eleven5150/smart-storage/README.md

# Smart storage
This project is my bachelor's degree work
