eleven5150/smart-storage/docs/РТЗ.docx

Gerb-BMSTU_01

| Министерство науки и высшего образования Российской Федерации Федеральное государственное бюджетное образовательное учреждение высшего образования «Московский государственный технический университет имени Н.Э. Баумана (национальный исследовательский университет)» (МГТУ им. Н.Э. Баумана)

ФАКУЛЬТЕТ «ИНФОРМАТИКА И СИСТЕМЫ УПРАВЛЕНИЯ» (ИУ)

КАФЕДРА «ПРОЕКТИРОВАНИЕ И ТЕХНОЛОГИЯ ПРОИЗВОДСТВА ЭА» (ИУ4)

РАСШИРЕННОЕ ТЕХНИЧЕСКОЕ ЗАДАНИЕ

на выполнение выпускной квалификационной

работы бакалавра

Тема квалификационной работы: «Устройство управления учетом электронных компонентов»

Студент ИУ4-83Б _________________ Кутаев К.С.

(Группа) (Подпись, дата)

Руководитель ВКР _________________ Гладких А.А.

(Подпись, дата)

Москва, 2022

# 1.1 НАИМЕНОВАНИЕ, НАЗНАЧЕНИЕ И ОБЛАСТЬ ПРИМЕНЕНИЯ.

1.1.1 Наименование разрабатываемого изделия – «Устройство управления учетом электронных компонентов».

1.1.2 Изделие предназначено для быстрого поиска места нахождения определенного электронного компонента в большом стеллаже или складе, а также для удобного ведения учета электронных компонентов и их быстрого добавления.

1.1.3 Применяется на рабочем месте инженеров-электронщиков, в небольших лабораториях электроники в виде устройства со светодиодной лентой, установленного на стеллаж с компонентами с возможностью подсветки ячейки, в которой находится нужный компонент.

1.1.4 «Устройство управления учетом электронных компонентов» подключается по Wi-Fi к серверу с базой данных, в которой хранятся электронные компоненты из стеллажа. Сервер расположен на одноплатном компьютере, подключенным к одной сети с устройством. На плате находится RFID считыватель, с возможностью считывания с RFID-меток информации о новых компонентах и добавления их в базу данных.

1.2 ОСНОВАНИЕ ДЛЯ РАЗРАБОТКИ.

1.2.1 Настоящее техническое задание разработано в соответствии с заданием ВКР бакалавра кафедры ИУ4 МГТУ им Н. Э. Баумана.

1.3 ЦЕЛЬ И НАЗНАЧЕНИЕ РАЗРАБОТКИ.

1.3.1 Цель разработки – создание «Устройства управления учетом электронных компонентов», предназначенного для быстрого поиска места нахождения определенного электронного компонента в большом стеллаже или складе, а также для удобного ведения учета электронных компонентов и их быстрого добавления.

1.3.2 «Устройство управления учетом электронных компонентов» должно иметь питание, достаточное для нормальный работы светодиодной ленты и работать в климатических условиях УХЛ 3.1.

# 1.4 ИСТОЧНИКИ РАЗРАБОТКИ.

1.4.1 Опыт, накопленный студентом в разработке устройств, использующих светодиоды в качестве индикации и опыт работы с базами данных.

1.4.2 Анализ источников информации об аналогах.

# 1.5 ПРИНЦИП ДЕЙСТВИЯ.

1.5.1 Для включения устройства необходимо подключить устройство к сети питания постоянного тока 5В по средствам USB кабеля USB Type-A на Micro-USB Type-B. После подачи питания на «Устройство управления учетом электронных компонентов» загорится светодиод, означающий правильную работу устройства.

Функционал режимов подсветки и добавления компонентов регулируются соответствующей версией внутреннего программного обеспечения УУЭК, в зависимости от назначения поставки, загружаемого непосредственно при выполнении заказа.

При передаче на Устройство данных о ячейке стеллажа, которую необходимо подсветить, Устройство зажигает необходимые светодиоды. Выключение подсветки происходит при бездействии в течении определенного времени, определяемого версией прошивки.

# 1.6 ОБЪЕКТ ОБРАБОТКИ.

1.6.1 Объект обработки – информация о номере ячейки, получаемая с предусмотренных в изделии устройств ввода.

# 1.7 ТЕХНИЧЕСКИЕ ТРЕБОВАНИЯ.

## 1.7.1 Требования по составу изделия.

1.7.1.1 Устройство управления учетом электронных компонентов предназначено для быстрого поиска места нахождения определенного компонента в большом стеллаже или складе, ведения учета компонентов в наличии, а также возможности быстрого добавления новых компонентов в базу данных с помощью RFID-меток.

1.7.1.2 В состав каждого изделия должны входить:

- «Устройство управления учетом электронных компонентов», далее по тексту УУЭК, со средствами упаковки, обеспечивающими его транспортирование и хранение;

- Одноплатный компьютер, с объемом постоянной памяти не менее 8 Гб, наличием Wi-Fi передатчика и возможностью установки операционной системы на основе ядра Linux;

- принадлежности и эксплуатационная документация, необходимые для выполнения работ по обслуживанию УУЭК в условиях эксплуатации и хранения;

1.7.1.3 Комплект ПО, необходимого для эксплуатации УУЭК:

- тестирование (подготовка к работе);

- копирования данных (перенос данных в персональный компьютер);

- расшифровки данных (получение и передача информации, хранящейся на внутренней flash-памяти).

1.7.1.4 В состав устройства входят:

- МК STM32F103RDT6;

- кварцевый резонатор;

- 74 керамических конденсатора;

- импульсный регулятор питания;

- 61 светодиод;

- предохранитель;

- катушка индуктивности;

- 13 резисторов;

- ползунковый переключатель;

- тактовая кнопка;

- транзистор;

- вилка штыревая;

- гнездо контактное.

1.7.1.5 Разрабатываемое устройство должно быть выполнено в виде одноплатной электронной ячейки на двухсторонней печатной плате, заключенной в прямоугольный пластмассовый корпус.

## 1.7.2 Требования по назначению.

1.7.2.1 УУЭК должно обеспечивать прием и передачу информации, хранящейся на внутренней flash-памяти;

1.7.2.2 Изделие должно обеспечивать:

- вывод графической информации о нахождении компонента на светодиодной ленте;

- возможность ведения учета электронных компонентов в базе данных, и доступ к ней через веб-страницу;

- возможность ввода информации посредством веб-страницы, с последующей передачей данных по Wi-Fi и ввод посредством RFID считывателя;

1.7.2.4 Погрешность определения времени считывания данных с RFID-метки не должна превышать 2 с;

1.7.2.5 Электрическая прочность и сопротивление изоляции УУЭК – по ГОСТ Р 52931;

1.7.2.6 Напряжение питания – 5 В с погрешностью 0,5 В. Ток для питания УУЭК, обеспечиваемое ресурсом источника питания, - не менее 1 Ампера.

1.7.2.7 УУЭК должно сохранять работоспособность при температуре окружающей среды от -10 °C до 40 °C и относительной влажности воздуха 60% при температуре 25 °C.

1.7.2.8 Устройство должен сохранять работоспособность после его транспортирования и хранения при температуре (от минус 25 °C до 50 °C) в среде без агрессивных примесей (кислот, щелочей и др.).

1.7.2.9 Устройство должен сохранять работоспособность при воздействии на него вибрации на диапазоне частот от 10 до 100 Гц по ГОСТ 28203-89.

1.7.2.10 Устройство должен сохранять работоспособность при воздействии на него ударных нагрузок с ускорением до 10g длительностью до 15 мс и частотой от 40 до 80 1/мин. Вибрация в диапазоне частот от 10 до 100 Гц с ускорением до 1,5 g.

1.7.2.11 Масса Устройства - не более 0,3 кг.

1.7.2.12 Потребляемая мощность устройства не превышает 3 Вт.

1.7.2.13 Максимальный потребляемый ток – 500 мА.

1.7.2.14 Технология беспроводной передачи данных – Wi-Fi.

1.7.2.15 Максимальное количество зажигаемых светодиодов на светодиодной ленте – 6 шт.

1.7.2.15 Заданный объём выпуска Nвып= 1000 шт./год.

1.7.2.16 IP адреса устройств назначаются вручную при установке системы.

## 1.7.3 Требования к надежности.

1.7.3.1 Установленная вероятность безотказной работы УУЭК в течение наработки не менее 5000 часов должна быть не менее 0,95.

1.7.3.2 Средний срок службы УУЭК не менее 1,5 лет. Установленный срок службы - 1 год.

## 1.7.4 Требования к уровню унификации и стандартизации.

1.7.4.1 Требования к уровню унификации и стандартизации не предъявляются.

## 1.7.5 Требования безопасности и требования по охране природы.

1.7.5.1 УУЭК должен быть безопасными при использовании его пользователем, прочитавшим правилам эксплуатации устройства.

1.7.5.2 Блок питания и его компоненты должны быть правильно утилизированы.

1.7.5.3 В эксплуатационной документации на Устройство должны быть ссылки на общие требования безопасности в соответствии со следующими документами:

- ГОСТ 12.3.019 Испытания и измерения электрические. Общие требования безопасности;

- ГОСТ 12.2.003 Оборудование производственное. Общие требования безопасности;

- ГОСТ 12.3.020 Процессы перемещения грузов на предприятиях. Общие требования безопасности;

- ГОСТ 12.2.007.0 Изделия электротехнические. Общие требования безопасности;

- ГОСТ 12.1.004 Пожарная безопасность. Общие требования;

- ГОСТ 12.3.002 Процессы производственные. Общие требования безопасности;

1.7.5.4 Требования по охране природы не предъявляются, так как при изготовлении, эксплуатации, транспортировании, хранении, утилизации УУЭК отсутствуют вредные воздействия на элементы окружающей среды.

## 1.7.6 Требования к составным частям, сырью и исходным материалам.

## 1.7.6.1 Покупные изделия и материалы применяются без ограничений.

## 1.7.7 Условия эксплуатации, требования к техническому обслуживанию и ремонту.

1.7.7.1 УУЭК должно быть выполнено для климатической зоны УХЛ 3.1 по ГОСТ 15150.

1.7.7.2 УУЭК должно сохранять работоспособность при температуре среды от -10 °C до 40 °C и относительной влажности воздуха 60% при температуре 25 °C.

1.7.7.3 УУЭК должно сохранять работоспособность после его транспортирования и хранения при температуре от минус 25 °C до 50 °C в среде без агрессивных примесей.

1.7.7.4 Техническое обслуживание УУЭК должно обеспечиваться при проведении работ по их подготовке к обследованию объектов контроля, работ после проведения контроля и работ по подготовке к хранению.

1.7.7.5 Для увеличения достоверности информации, получаемой с установленных устройств ввода и вывода, допускается проведение периодической проверки и калибровки.

## 1.7.8 Требования к маркировке и упаковке.

1.7.8.1 Требования к маркировке не предъявляются.

## 1.7.9 Требования к транспортированию и хранению.

1.7.9.1 УУЭК должно выдерживать транспортирование в пассажирских салонах всех видов транспорта без ограничения расстояния перевозки.

# 1.8 ПОРЯДОК КОНТРОЛЯ И ПРИЕМКИ

1.8.1 Для приемки представляется один опытный образец платы печатной УУЭК, комплект эксплуатационных документов, комплект программного обеспечения, программа и методика приемных испытаний, согласованная в установленном порядке.

1.8.2 Конструкторская и технологическая документация должна быть разработана в соответствии с требованиями ГОСТ ЕСКД.

1.8.3 В комплекты эксплуатационных документов должны быть включены следующие документы:

– схема электрическая структурная электронной ячейки УУЭК (Э1),

– схема электрическая структурная УУЭК (Э1),

– схема электрическая принципиальная УУЭК (Э3),

– перечень элементов электронной ячейки УУЭК (ПЭ),

– чертеж печатной платы УУЭК(ПП),

– сборочный чертеж электронной ячейки УУЭК(СБ),

– спецификация электронной ячейки УУЭК(СП),

– чертежи основания и крышки корпуса УУЭК,

– сборочный чертёж УУЭК,

– спецификация УУЭК(СП),

– эскизный технологический процесс сборки УУЭК,

– алгоритм работы УУЭК,

– расчётно-пояснительная записка.

1.8.4 Приемные испытания УУЭК проводятся на образцах с искусственными или естественными дефектами, предоставляемыми заказчиком.

1.8.5 По результатам проведения испытаний, при необходимости проводится корректировка конструкторской документации.

1.8.6 Отдельные требования настоящего технического задания могут изменяться и дополняться по согласованию сторон в установленном порядке.
