eleven5150/smart-storage/cad-src/case/g1098b-g1098g.png

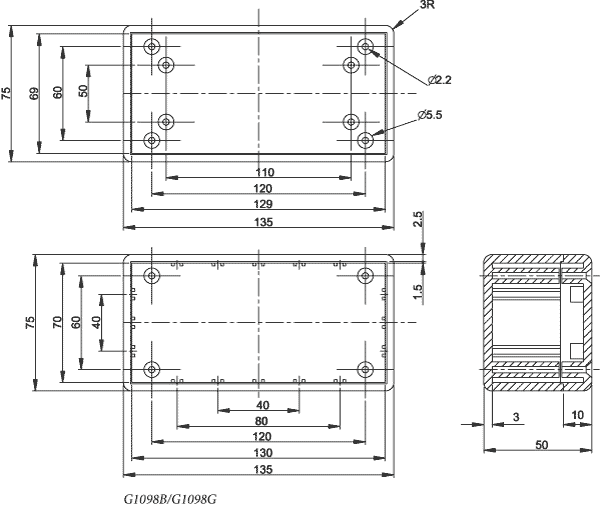
cad-src/case/g1098b-g1098g.png
