eleven5150/smart-storage/cad-src/case/Gainta G1098.STEP

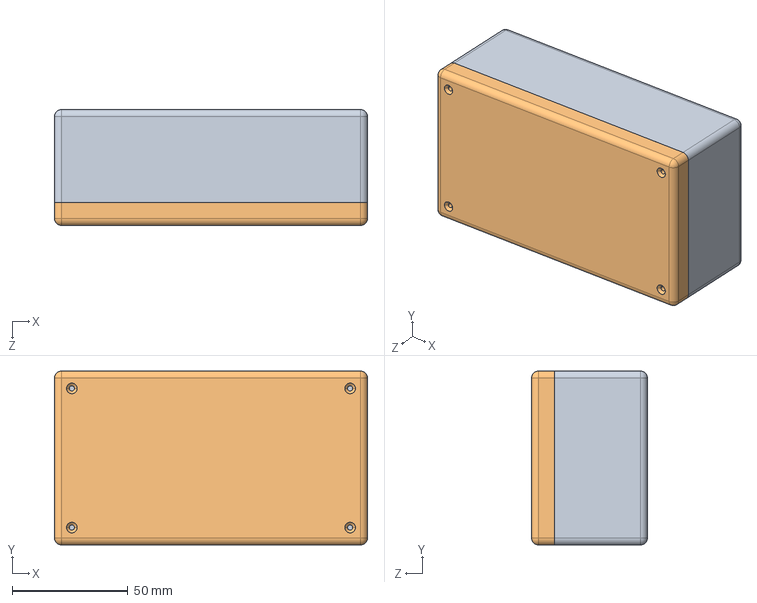
[picture p3: CAD file, 2022-06-20]
cad-src/case/Gainta G1098.STEP
135.0 x 75.0 x 50.0 mm
ﾎ魵瑙韃
Êðûøêà
