eleven5150/smart-storage/(list of files, cad)

Other CAD files:
cad-src/Altium/Diplom/Project Outputs for Diplom/AssemblyA.dwg
cad-src/Altium/Diplom/Project Outputs for Diplom/InventorNew/Assembly.dwg
cad-src/Altium/Diplom/Project Outputs for Diplom/AssemblyANew.dwg
cad-src/Altium/Diplom/Project Outputs for Diplom/Inventor/Сборочный.dwg
docs/Device/СП.dwg
docs/for print/Page2.dwg
docs/PCB/Э3.dwg
cad-src/Altium/Diplom/Project Outputs for Diplom/Inventor/PCBDiplomPCB.dwg
cad-src/case/Device.dwg
docs/Device/Алгоритм.dwg
docs/for print/Page1.dwg
docs/PCB/СборочныйA2.dwg
docs/Device/Эксперимент.dwg
docs/for print/Page3.dwg
docs/PCB/ПЭ3.dwg
docs/Device/Сборочный.dwg
docs/PCB/Сборочный.dwg
docs/Device/Крышка.dwg
docs/PCB/СП.dwg
docs/Device/Последовательность сборки.dwg
docs/PCB/ПП.dwg
docs/Device/ЭкспериментA3.dwg
docs/PCB/E1.dwg
docs/Device/Основание.dwg
docs/Device/E1 connection.dwg
docs/Device/Измерительный стенд.dwg
cad-src/Altium/Diplom/Project Outputs for Diplom/Inventor/PCB444.ipt
cad-src/Altium/Diplom/Project Outputs for Diplom/Inventor/PCB7459956112.iam
cad-src/Altium/Diplom/Project Outputs for Diplom/Inventor/PCBBoard.iam
cad-src/Altium/Diplom/Project Outputs for Diplom/Inventor/PCBC1.iam
cad-src/Altium/Diplom/Project Outputs for Diplom/Inventor/PCBC10.iam
cad-src/Altium/Diplom/Project Outputs for Diplom/Inventor/PCBC11.iam
cad-src/Altium/Diplom/Project Outputs for Diplom/Inventor/PCBC12.iam
cad-src/Altium/Diplom/Project Outputs for Diplom/Inventor/PCBC13.iam
cad-src/Altium/Diplom/Project Outputs for Diplom/Inventor/PCBC14.iam
cad-src/Altium/Diplom/Project Outputs for Diplom/Inventor/PCBC2.iam
cad-src/Altium/Diplom/Project Outputs for Diplom/Inventor/PCBC3.iam
cad-src/Altium/Diplom/Project Outputs for Diplom/Inventor/PCBC4.iam
cad-src/Altium/Diplom/Project Outputs for Diplom/Inventor/PCBC5.iam
cad-src/Altium/Diplom/Project Outputs for Diplom/Inventor/PCBC6.iam
cad-src/Altium/Diplom/Project Outputs for Diplom/Inventor/PCBC7.iam
cad-src/Altium/Diplom/Project Outputs for Diplom/Inventor/PCBC8.iam
cad-src/Altium/Diplom/Project Outputs for Diplom/Inventor/PCBC9.iam
cad-src/Altium/Diplom/Project Outputs for Diplom/Inventor/PCBCDRH104R.iam
cad-src/Altium/Diplom/Project Outputs for Diplom/Inventor/PCBDA1.iam
cad-src/Altium/Diplom/Project Outputs for Diplom/Inventor/PCBDD1.iam
cad-src/Altium/Diplom/Project Outputs for Diplom/Inventor/PCBDiplomPCB.iam
cad-src/Altium/Diplom/Project Outputs for Diplom/Inventor/PCBExtruded.ipt
cad-src/Altium/Diplom/Project Outputs for Diplom/Inventor/PCBF1.iam
cad-src/Altium/Diplom/Project Outputs for Diplom/Inventor/PCBFUSRC4632X90N.ipt
cad-src/Altium/Diplom/Project Outputs for Diplom/Inventor/PCBHL1.iam
cad-src/Altium/Diplom/Project Outputs for Diplom/Inventor/PCBL1.iam
cad-src/Altium/Diplom/Project Outputs for Diplom/Inventor/PCBLQFP64-10x10mm.ipt
cad-src/Altium/Diplom/Project Outputs for Diplom/Inventor/PCBOpen CASCADE STEP translator 6.8 1.1.1.ipt
cad-src/Altium/Diplom/Project Outputs for Diplom/Inventor/PCBPBD-8.ipt
cad-src/Altium/Diplom/Project Outputs for Diplom/Inventor/PCBR1.iam
cad-src/Altium/Diplom/Project Outputs for Diplom/Inventor/PCBR2.iam
cad-src/Altium/Diplom/Project Outputs for Diplom/Inventor/PCBR3.iam
cad-src/Altium/Diplom/Project Outputs for Diplom/Inventor/PCBR4.iam
cad-src/Altium/Diplom/Project Outputs for Diplom/Inventor/PCBR5.iam
cad-src/Altium/Diplom/Project Outputs for Diplom/Inventor/PCBR6.iam
cad-src/Altium/Diplom/Project Outputs for Diplom/Inventor/PCBR7.iam
cad-src/Altium/Diplom/Project Outputs for Diplom/Inventor/PCBSA1.iam
cad-src/Altium/Diplom/Project Outputs for Diplom/Inventor/PCBSB1.iam
cad-src/Altium/Diplom/Project Outputs for Diplom/Inventor/PCBSOT23-5.ipt
cad-src/Altium/Diplom/Project Outputs for Diplom/Inventor/PCBUser_Library-FYLS-1206.ipt
cad-src/Altium/Diplom/Project Outputs for Diplom/Inventor/PCBUser_Library-GeyerElectronics_KX7.ipt
cad-src/Altium/Diplom/Project Outputs for Diplom/Inventor/PCBUser_Library-PBS-08.ipt
cad-src/Altium/Diplom/Project Outputs for Diplom/Inventor/PCBUser_Library-PLS-1R.ipt
cad-src/Altium/Diplom/Project Outputs for Diplom/Inventor/PCBUser_Library-RES_2013-0805.ipt
cad-src/Altium/Diplom/Project Outputs for Diplom/Inventor/PCBUser_Library-SMD_CAPACITOR0805.ipt
cad-src/Altium/Diplom/Project Outputs for Diplom/Inventor/PCBUser_Library-SWT-34.ipt
cad-src/Altium/Diplom/Project Outputs for Diplom/Inventor/PCBUser_Library-cdrh104r_CDRH104R_KORPUS.ipt
cad-src/Altium/Diplom/Project Outputs for Diplom/Inventor/PCBUser_Library-cdrh104r_CDRH104R_NOGKA.ipt
cad-src/Altium/Diplom/Project Outputs for Diplom/Inventor/PCBUser_Library-cdrh104r_CDRH104R_NOGKA_1.ipt
cad-src/Altium/Diplom/Project Outputs for Diplom/Inventor/PCBUser_Library-micro_usb_SMD.ipt
cad-src/Altium/Diplom/Project Outputs for Diplom/Inventor/PCBUser_Library-sot23-1.ipt
cad-src/Altium/Diplom/Project Outputs for Diplom/Inventor/PCBVT1.iam
cad-src/Altium/Diplom/Project Outputs for Diplom/Inventor/PCBXP1.iam
cad-src/Altium/Diplom/Project Outputs for Diplom/Inventor/PCBXP2.iam
cad-src/Altium/Diplom/Project Outputs for Diplom/Inventor/PCBXS1.iam
cad-src/Altium/Diplom/Project Outputs for Diplom/Inventor/PCBXS2.iam
cad-src/Altium/Diplom/Project Outputs for Diplom/Inventor/PCBXS3.iam
cad-src/Altium/Diplom/Project Outputs for Diplom/Inventor/PCBXS4.iam
cad-src/Altium/Diplom/Project Outputs for Diplom/Inventor/PCBZQ1.iam
cad-src/Altium/Diplom/Project Outputs for Diplom/Inventor/Крышка.ipt
cad-src/Altium/Diplom/Project Outputs for Diplom/Inventor/Основание.ipt
cad-src/Altium/Diplom/Project Outputs for Diplom/InventorNew/PCB444.ipt
cad-src/Altium/Diplom/Project Outputs for Diplom/InventorNew/PCB7202516656.iam
cad-src/Altium/Diplom/Project Outputs for Diplom/InventorNew/PCBBoard.iam
cad-src/Altium/Diplom/Project Outputs for Diplom/InventorNew/PCBC1.iam
cad-src/Altium/Diplom/Project Outputs for Diplom/InventorNew/PCBC10.iam
cad-src/Altium/Diplom/Project Outputs for Diplom/InventorNew/PCBC11.iam
cad-src/Altium/Diplom/Project Outputs for Diplom/InventorNew/PCBC12.iam
cad-src/Altium/Diplom/Project Outputs for Diplom/InventorNew/PCBC13.iam
cad-src/Altium/Diplom/Project Outputs for Diplom/InventorNew/PCBC14.iam
cad-src/Altium/Diplom/Project Outputs for Diplom/InventorNew/PCBC2.iam
cad-src/Altium/Diplom/Project Outputs for Diplom/InventorNew/PCBC3.iam
cad-src/Altium/Diplom/Project Outputs for Diplom/InventorNew/PCBC4.iam
cad-src/Altium/Diplom/Project Outputs for Diplom/InventorNew/PCBC5.iam
cad-src/Altium/Diplom/Project Outputs for Diplom/InventorNew/PCBC6.iam
cad-src/Altium/Diplom/Project Outputs for Diplom/InventorNew/PCBC7.iam
cad-src/Altium/Diplom/Project Outputs for Diplom/InventorNew/PCBC8.iam
cad-src/Altium/Diplom/Project Outputs for Diplom/InventorNew/PCBC9.iam
cad-src/Altium/Diplom/Project Outputs for Diplom/InventorNew/PCBCDRH104R.iam
cad-src/Altium/Diplom/Project Outputs for Diplom/InventorNew/PCBDA1.iam
cad-src/Altium/Diplom/Project Outputs for Diplom/InventorNew/PCBDD1.iam
cad-src/Altium/Diplom/Project Outputs for Diplom/InventorNew/PCBDiplomPCB.iam
cad-src/Altium/Diplom/Project Outputs for Diplom/InventorNew/PCBESP8266-ESP01.iam
cad-src/Altium/Diplom/Project Outputs for Diplom/InventorNew/PCBExtruded.ipt
cad-src/Altium/Diplom/Project Outputs for Diplom/InventorNew/PCBF1.iam
cad-src/Altium/Diplom/Project Outputs for Diplom/InventorNew/PCBFUSRC4632X90N.ipt
cad-src/Altium/Diplom/Project Outputs for Diplom/InventorNew/PCBHL1.iam
cad-src/Altium/Diplom/Project Outputs for Diplom/InventorNew/PCBL1.iam
cad-src/Altium/Diplom/Project Outputs for Diplom/InventorNew/PCBLQFP64-10x10mm.ipt
cad-src/Altium/Diplom/Project Outputs for Diplom/InventorNew/PCBOpen CASCADE STEP translator 6.8 1.1.1.ipt
cad-src/Altium/Diplom/Project Outputs for Diplom/InventorNew/PCBOpen CASCADE STEP translator 6.8 1.13.2.1.ipt
cad-src/Altium/Diplom/Project Outputs for Diplom/InventorNew/PCBOpen CASCADE STEP translator 6.8 1.13.2.12.ipt
cad-src/Altium/Diplom/Project Outputs for Diplom/InventorNew/PCBOpen CASCADE STEP translator 6.8 1.13.2.13.ipt
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
