eleven5150/smart-storage/docs/for print/export/Page1.pdf

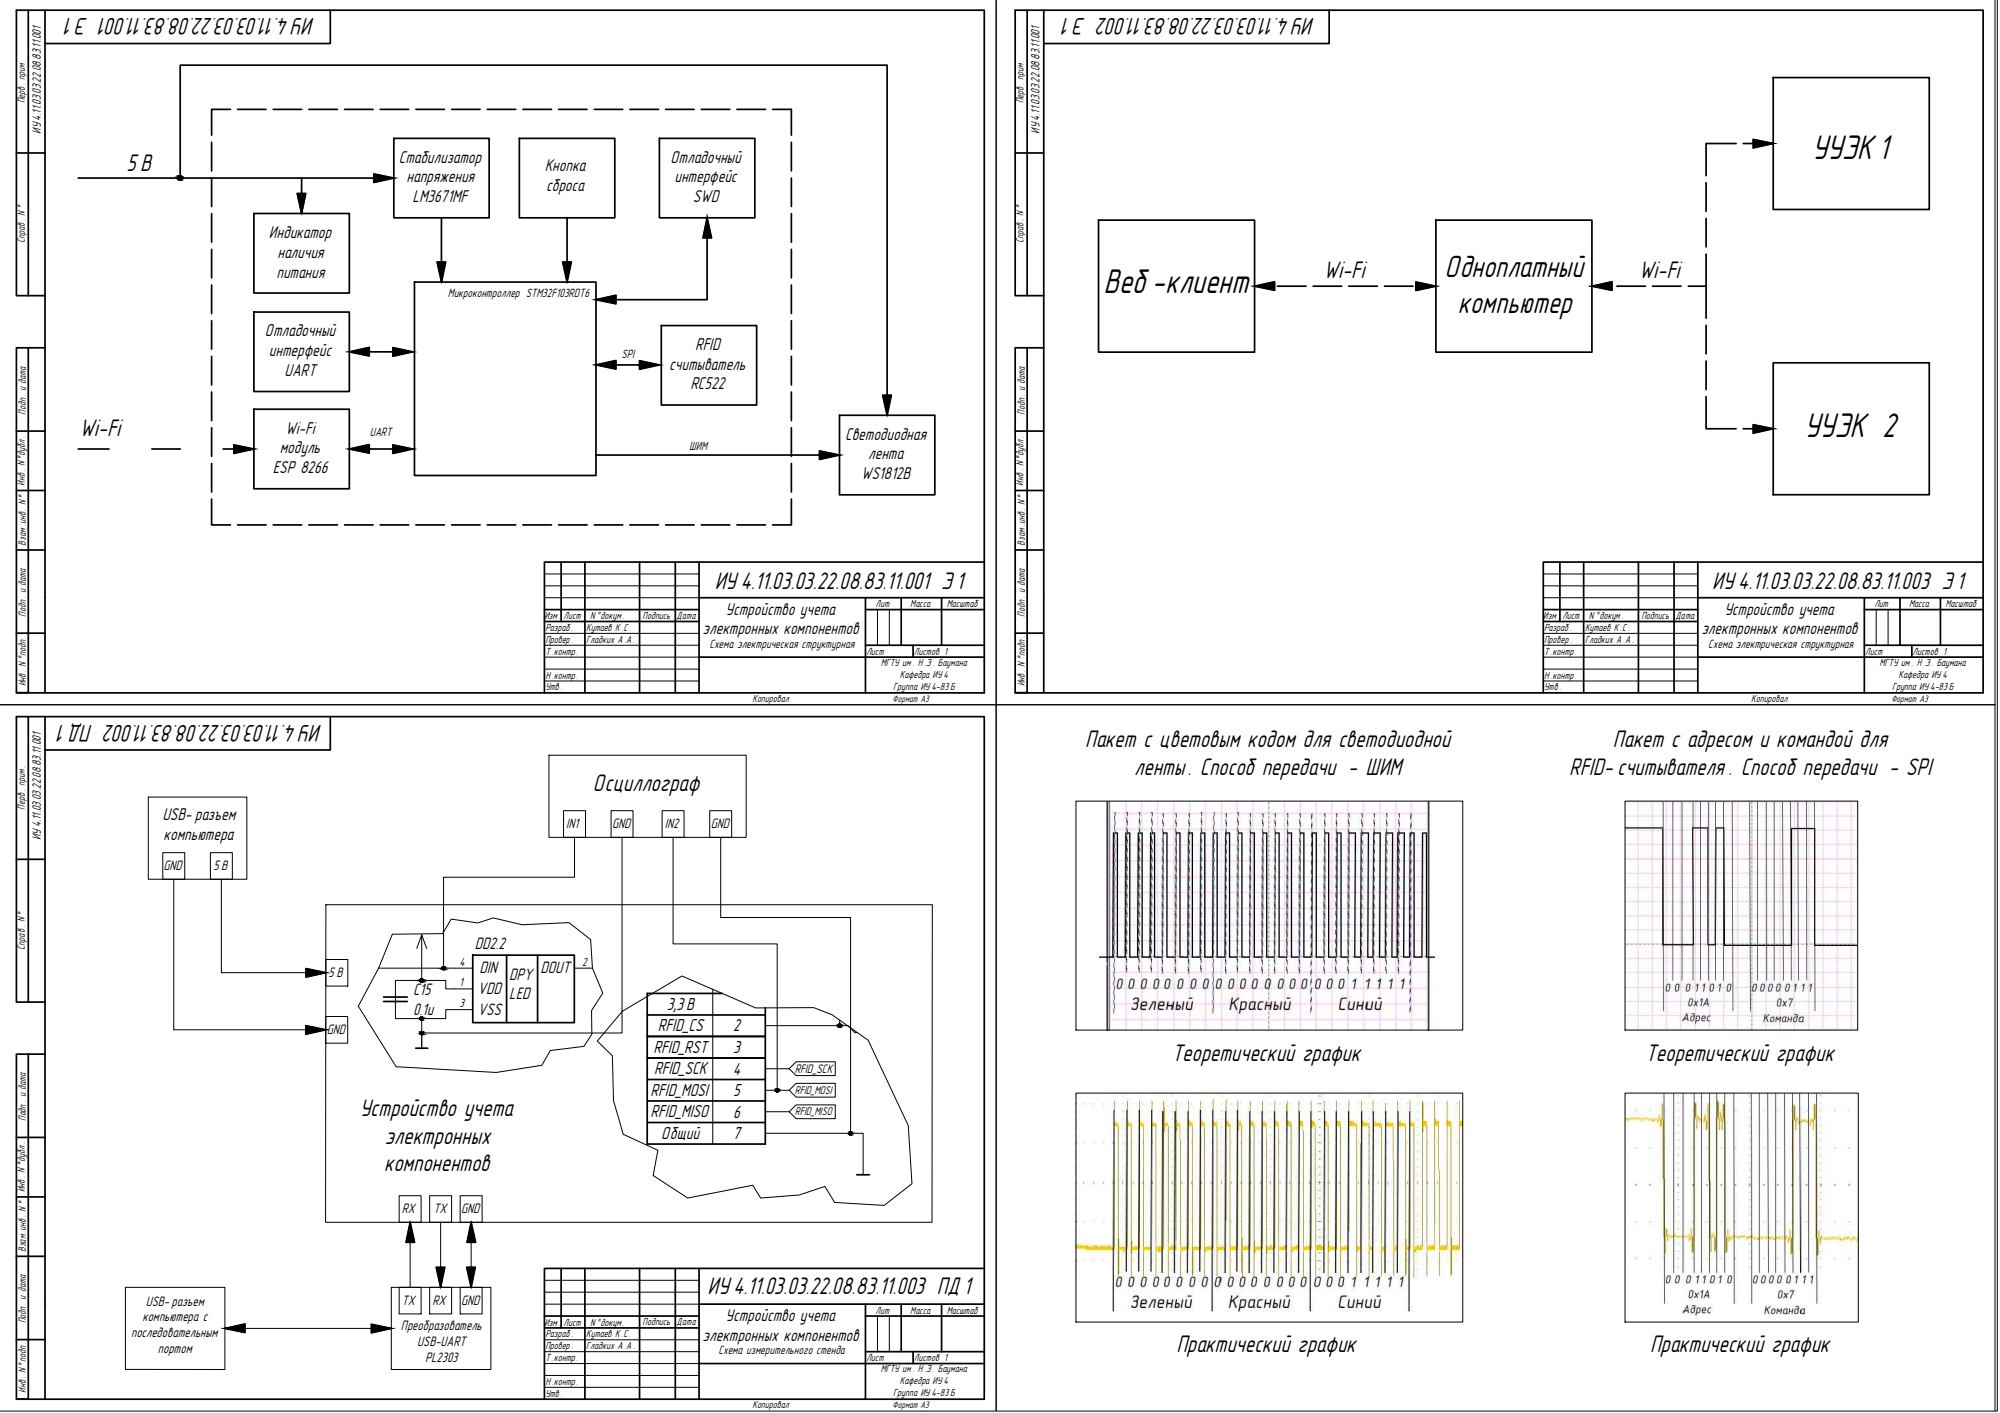
[picture p4: page 1]
Копировал; Формат А3; N °докум .; Подпись; Дата; Листов 1; Утв . Н .контр .; Кутаев К .С . Гладких А .А .; МГТУ им . Н .Э . Баумана; Кафедра ИУ 4 Группа ИУ 4-83 Б; Схема электрическая структурная Подп . и дата Инв . N °дубл . Подп . и дата Взам .инв . N ° Инв . N °подп . Перв . прим . Справ . N °; Микроконтроллер STM32F103RDT6; ESP 8266; Веб -клиент; УУЭК 1; УУЭК 2; Изм . Лист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

Лит Устройство учета
электронных компонентов

Изм . Лист
Провер . Т .контр . Разраб .

Пакет с цветовым кодом для светодиодной
ленты . Способ передачи - ШИМ

Пакет с адресом и командой для
RFID- считывателя . Способ передачи - SPI

DD2.2
DIN VDD | LED | DOUT DPY

RFID_RST | 3
RFID_SCK | 4
RFID_MOSI | 5

электронных компонентов | Лит Устройство учета | Масса | Масштаб

Лист | Листов 1

Утв . Н .контр .

Кафедра ИУ 4 Группа ИУ 4-83 Б
