eleven5150/smart-storage/docs/for print/export/Page4.pdf

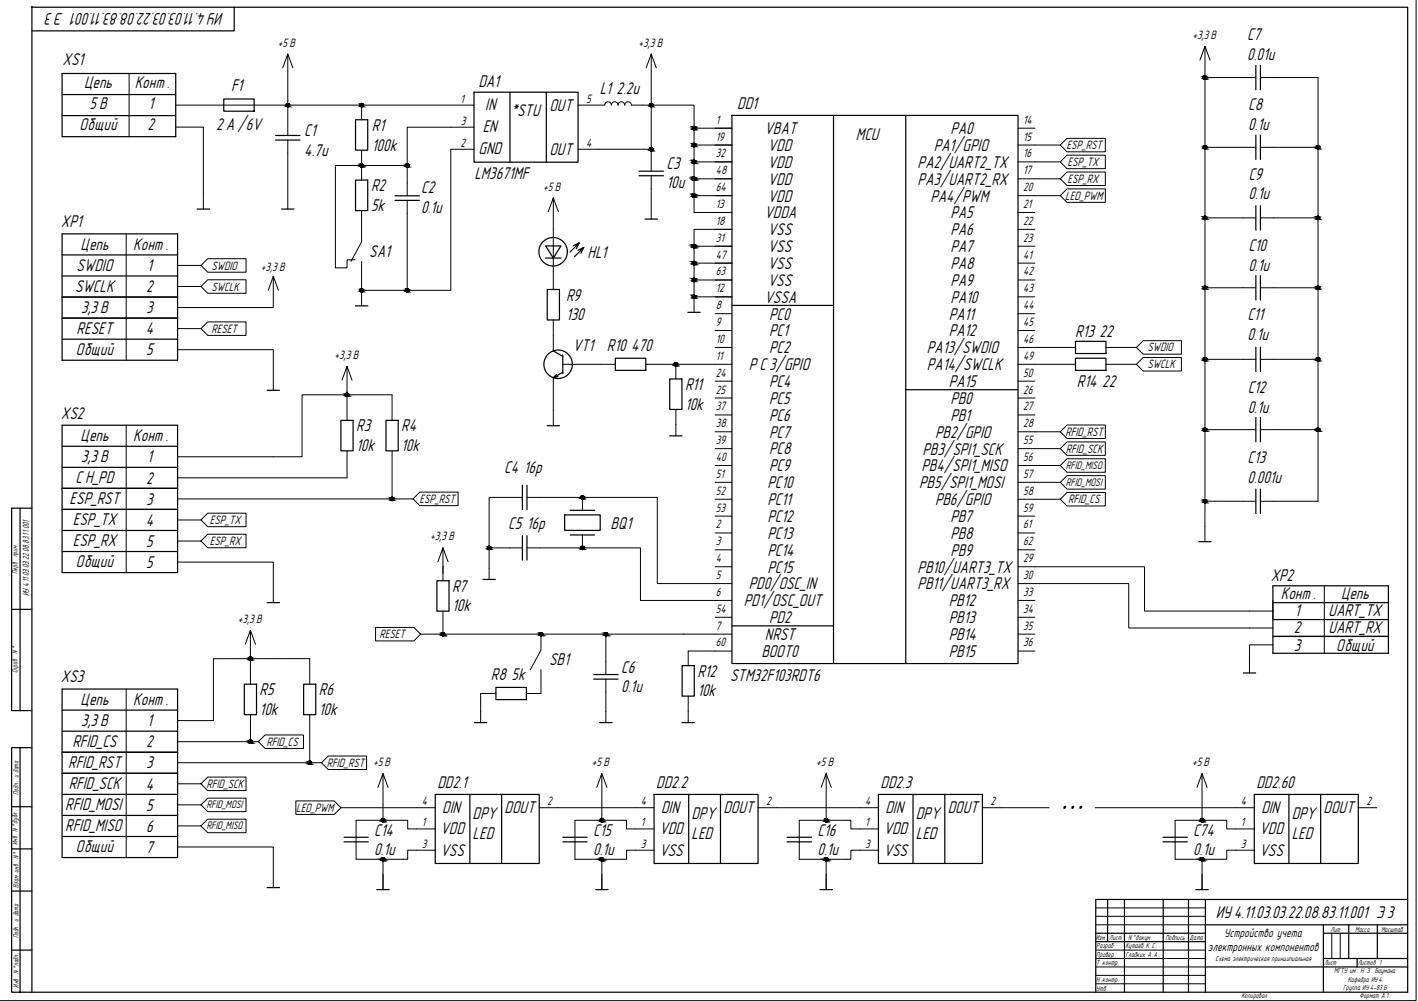
[picture p5: page 1]

31 | 23
47 | 41
63 | 42
12 | 43

Цепь | Конт . SWDIO 1

SWCLK | 2

RESET | 4
Общий | 5

Цепь | Конт .
3,3 В | 1
С H_PD | 2
ESP_RST | 3
ESP_TX | 4
ESP_RX | 5

Провер . Т .контр . Разраб . Перв . прим . Справ . N ° Подп . и дата Инв . N °дубл . Подп . и дата Взам .инв . N °

5 | | 30
6 | | 33

Конт . | Цепь
1 | UART_TX
2 | UART_RX
3 | Общий

RFID_CS | 2

электронных компонентов Схема электрическая принципиальная | Лит Устройство учета | Масса | Масштаб

Изм . Лист | N °докум . | Подпись | Дата

Утв . Н .контр . Инв . N °подп .

Лист | Листов 1

Кафедра ИУ 4 Группа ИУ 4-83 Б
