eleven5150/smart-storage/docs/Device/export/Измерительный стендA3.pdf

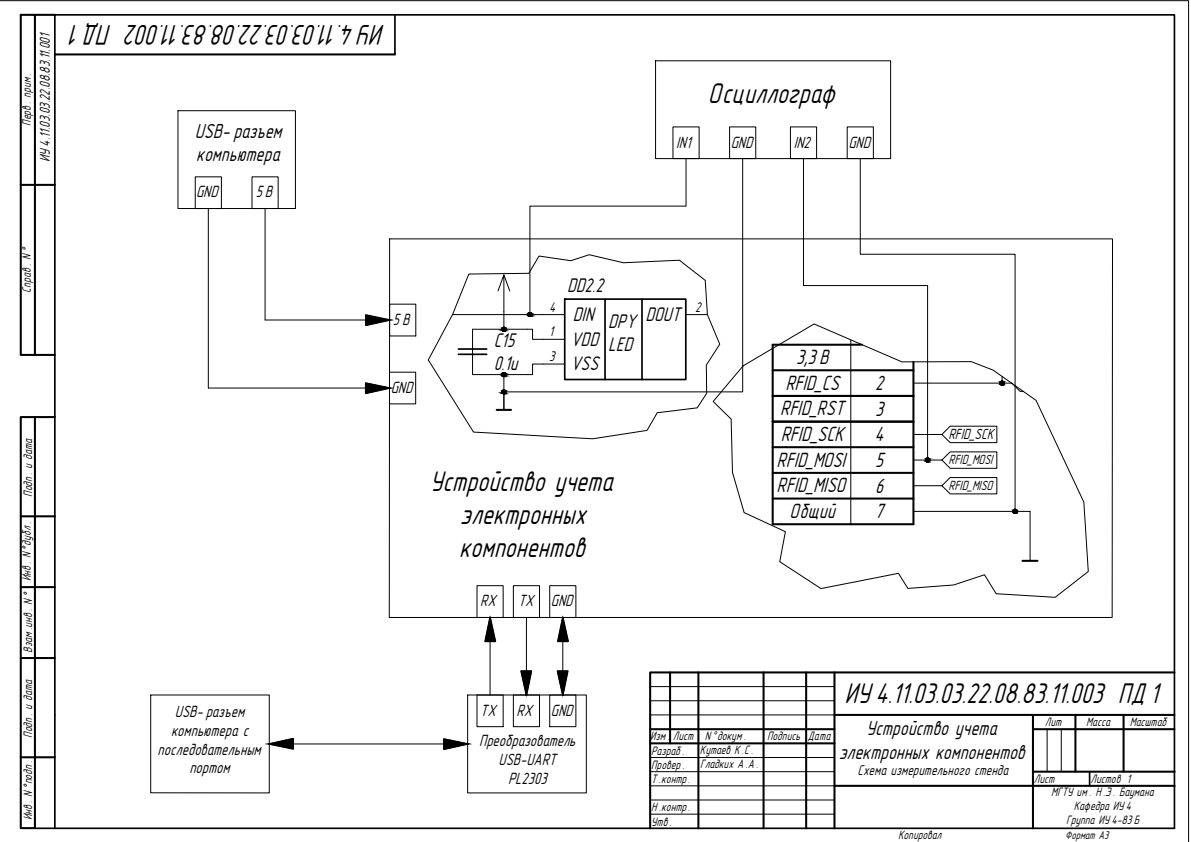
[picture p6: page 1]
Копировал; Формат А3; N °докум .; Подпись; Дата; Изм . Лист; Кутаев К .С . Гладких А .А .; МГТУ им . Н .Э . Баумана; Схема измерительного стенда Подп . и дата Инв . N °дубл . Подп . и дата Взам .инв . N ° Инв . N °подп . Перв . прим . Справ . N °; USB- разъем; GND; Устройство учета; компьютера с; VSS 3

DD2.2
DIN VDD | LED | DOUT DPY

RFID_RST | 3
RFID_SCK | 4
RFID_MOSI | 5

электронных компонентов | Лит Устройство учета | Масса | Масштаб

Провер . Т .контр . Разраб .

Лист | Листов 1

Утв . Н .контр .

Кафедра ИУ 4 Группа ИУ 4-83 Б
