eleven5150/smart-storage/docs/for print/export/Page5.pdf

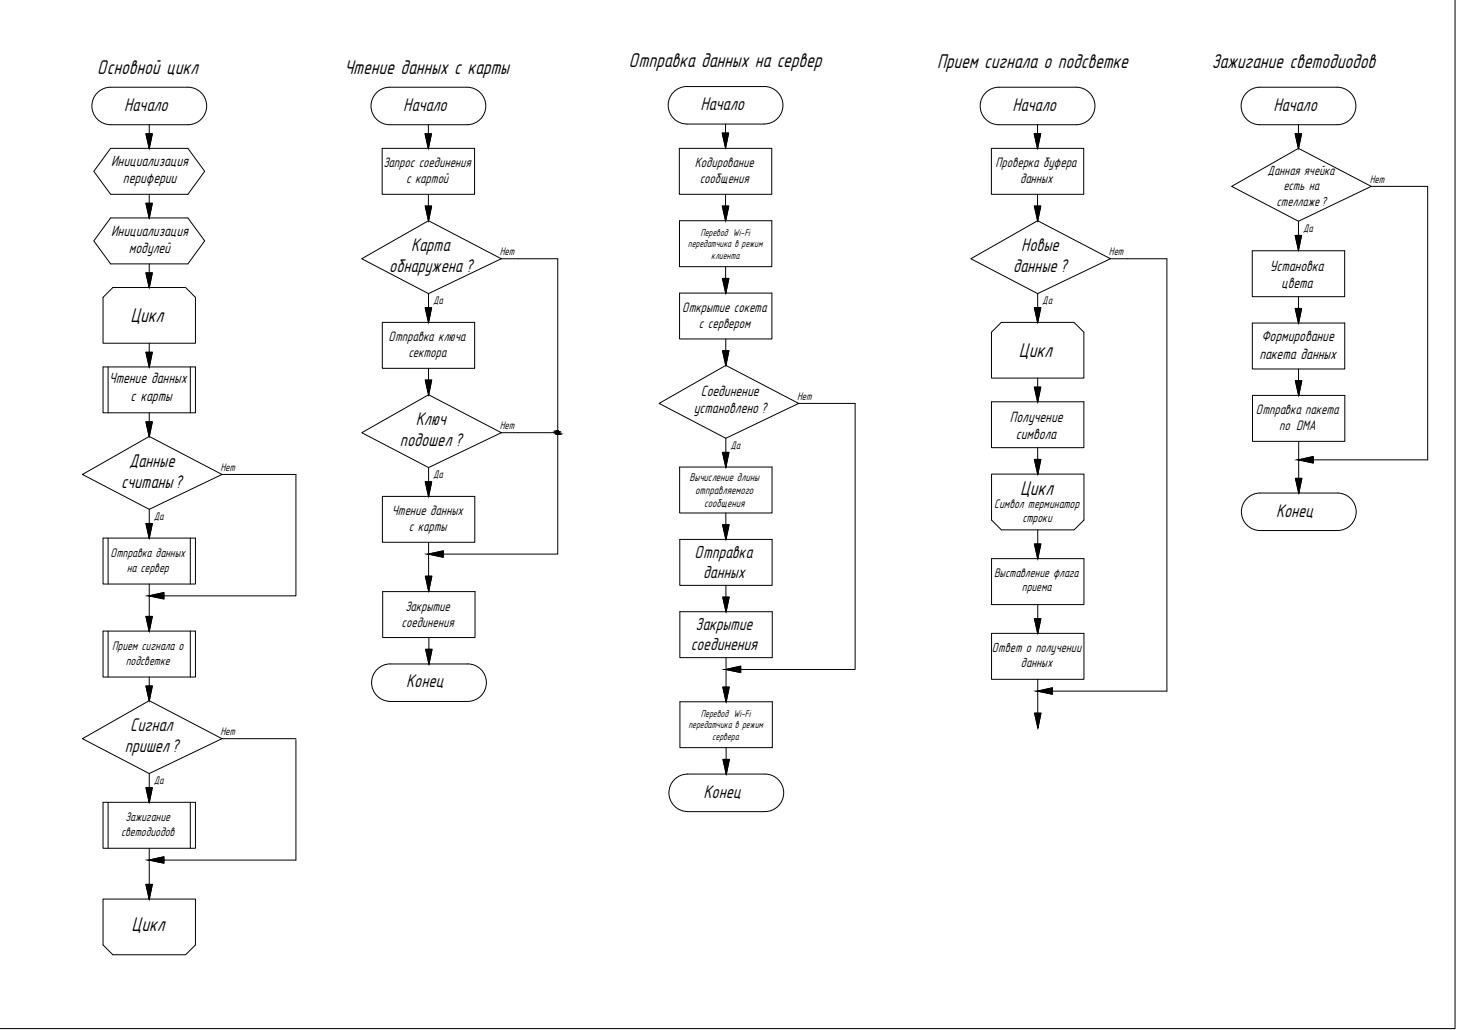
[picture p7: page 1]
Чтение данных с карты; считаны ?; Отправка данных на сервер; Прием сигнала о; пришел ?; Запрос соединения с картой; обнаружена ?; Отправка ключа; подошел ?; Открытие сокета с сервером; установлено ?; Вычисление длины; Проверка буфера; данные ?; Символ терминатор; Выставление флага; Ответ о получении; Основной цикл; Зажигание светодиодов; Данная ячейка есть на стеллаже ?; пакета данных; Отправка пакета по DMA

Отправка данных на сервер

Прием сигнала о подсветке

Чтение данных с карты

Перевод Wi-Fi
передатчика в режим
клиента

сервера
