eleven5150/smart-storage/docs/for print/export/Page6.pdf

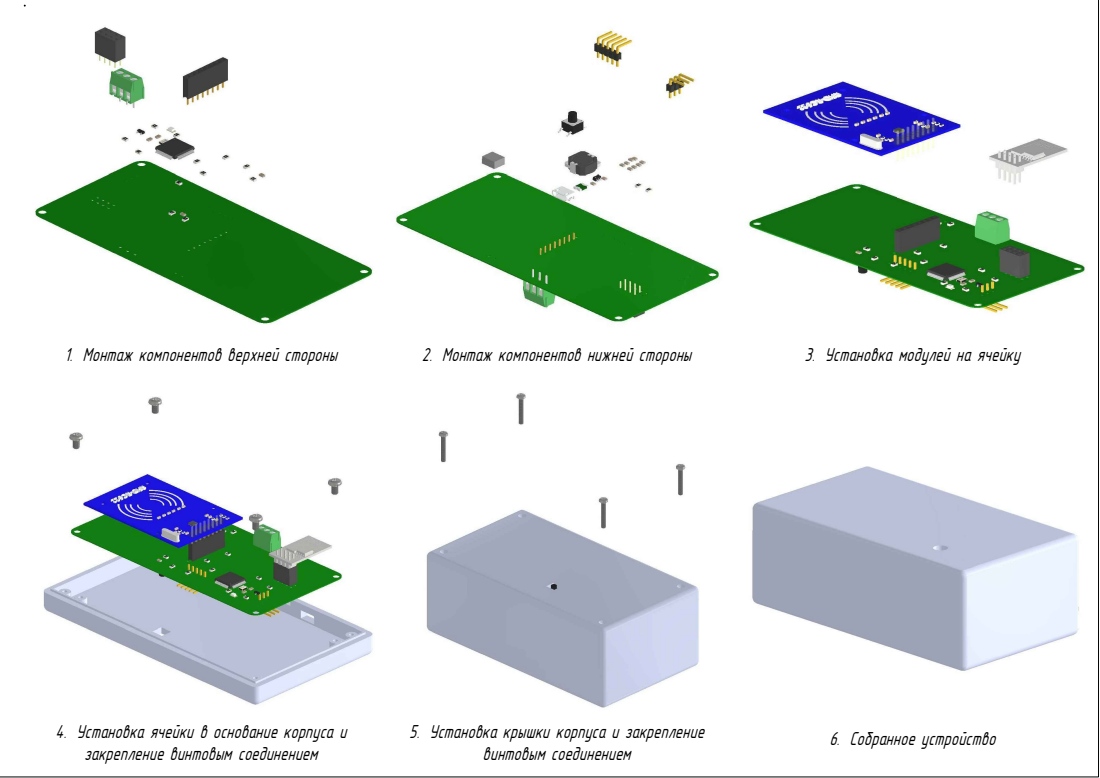
[picture p8: page 1]
1. Монтаж компонентов верхней стороны; 2. Монтаж компонентов нижней стороны; 3. Установка модулей на ячейку; винтовым соединением

4. Установка ячейки в основание корпуса и
закрепление винтовым соединением

6. Собранное устройство 5. Установка крышки корпуса и закрепление
