eleven5150/smart-storage/docs/Device/export/E1 connectionA3.pdf

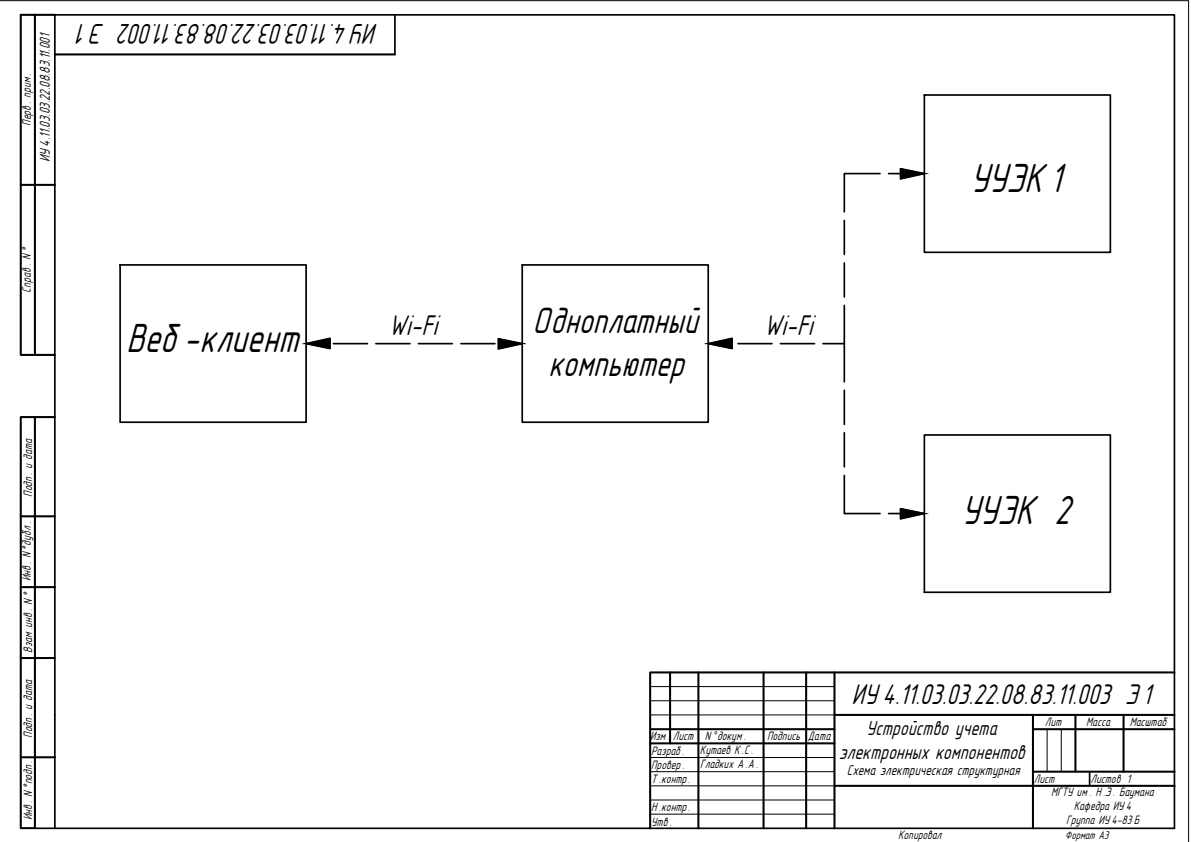
[picture p9: page 1]
Копировал; Формат А3; Кутаев К .С . Гладких А .А .; МГТУ им . Н .Э . Баумана; Схема электрическая структурная Подп . и дата Инв . N °дубл . Подп . и дата Взам .инв . N ° Инв . N °подп . Перв . прим . Справ . N °; Веб -клиент; Одноплатный; УУЭК 1; УУЭК 2

электронных компонентов | Лит Устройство учета | Масса | Масштаб

Изм . Лист | N °докум . | Подпись | Дата
Провер . Т .контр . Разраб .

Лист | Листов 1

Утв . Н .контр .

Кафедра ИУ 4 Группа ИУ 4-83 Б
