eleven5150/smart-storage/docs/Device/export/СборочныйA3.pdf

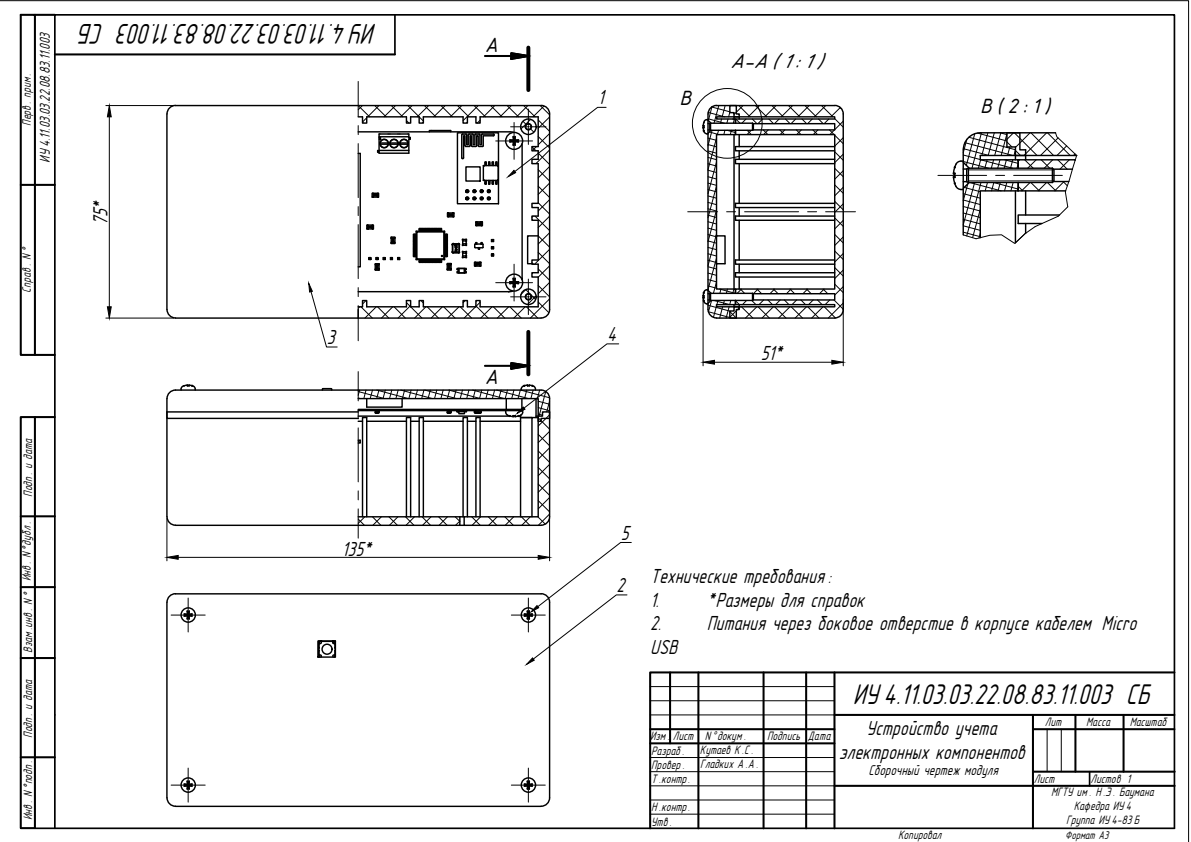
[picture p10: page 1]
Копировал; Формат А3; Кутаев К .С . Гладких А .А .; МГТУ им . Н .Э . Баумана; Сборочный чертеж модуля Подп . и дата Инв . N °дубл . Подп . и дата Взам .инв . N ° Инв . N °подп . Перв . прим . Справ . N °

Технические требования :
1. *Размеры для справок
2. Питания через боковое отверстие в корпусе кабелем Micro
USB

электронных компонентов | Лит Устройство учета | Масса | Масштаб

Изм . Лист | N °докум . | Подпись | Дата
Провер . Т .контр . Разраб .

Лист | Листов 1

Утв . Н .контр .

Кафедра ИУ 4 Группа ИУ 4-83 Б
