eleven5150/smart-storage/docs/Device/export/СП.pdf

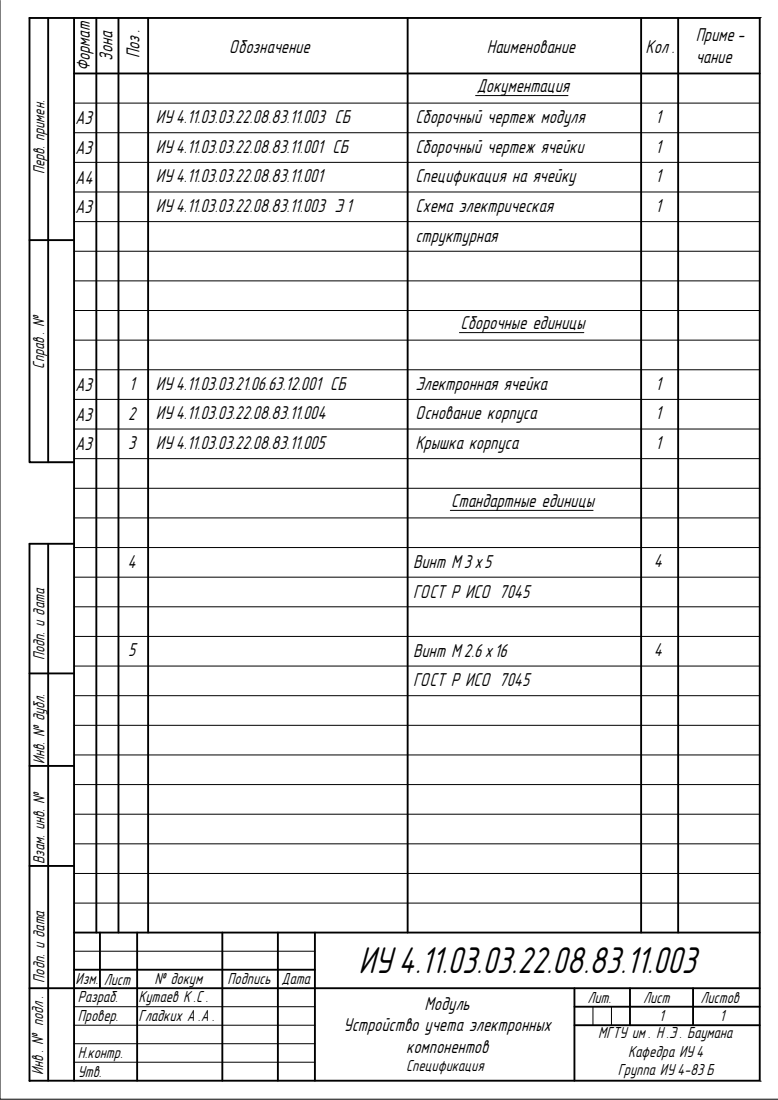
[picture p11: page 1]
Лист; № докум; Подпись; Дата; Наименование; Кол .; Приме -; Сборочный чертеж модуля; Схема электрическая; Спецификация на ячейку; Сборочные единицы; Электронная ячейка; Винт М 2.6 х 16; ГОСТ Р ИСО 7045; Винт М 3 х 5; Основание корпуса; Крышка корпуса; Стандартные единицы

Обозначение Поз . Зона Формат

Перв. примен. Взам. инв. № Подп. и дата

Сборочный чертеж ячейки

Листов Инв . № подл . Справ . №

Инв. № дубл. Подп. и дата

Разраб. | Кутаев К .С . Гладких А .А .
Провер.

Устройство учета электронных

МГТУ им . Н .Э . Баумана
Кафедра ИУ 4
Группа ИУ 4-83 Б
