eleven5150/smart-storage/docs/PCB/export/ППA2.pdf

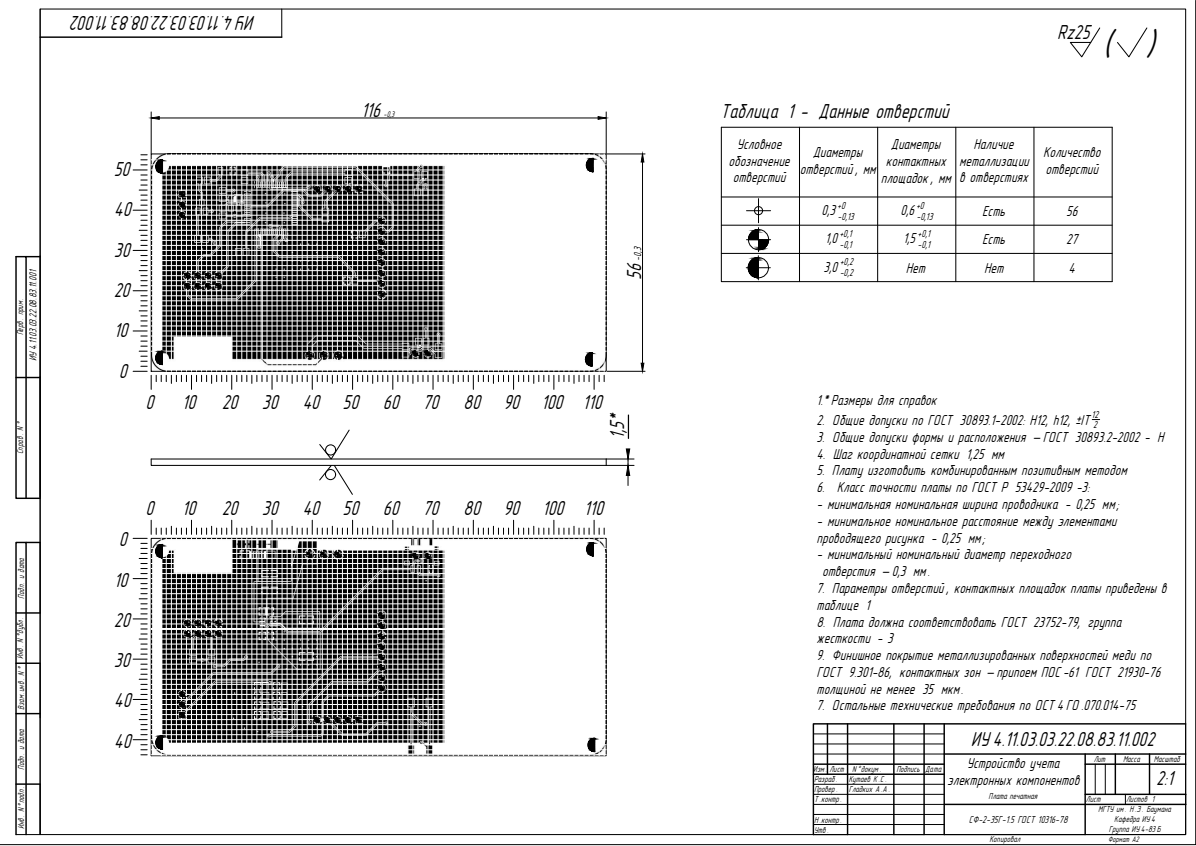
[picture p12: page 1]
Копировал; Формат А2

Таблица 1 - Данные отверстий

Условное обозначение отверстий | Диаметры отверстий , мм | Диаметры контактных площадок , мм | Наличие металлизации в отверстиях | Количество отверстий

+0 0,3 -0,13 | +0 0,6 -0,13 | Есть | 56

+0,1 1,0 -0,1 | +0,1 1,5 -0,1 | Есть | 27

+0,2 3,0 -0,2 | Нет | Нет | 4

1.* Размеры для справок
2. Общие допуски по ГОСТ 30893.1-2002: H12, h12, ±IT
3. Общие допуски формы и расположения – ГОСТ 30893.2-2002 - Н
4. Шаг координатной сетки 1,25 мм
5. Плату изготовить комбинированным позитивным методом
6. Класс точности платы по ГОСТ Р 53429-2009 -3:
- минимальная номинальная ширина проводника - 0,25 мм ;
- минимальное номинальное расстояние между элементами
проводящего рисунка - 0,25 мм ;
- минимальный номинальный диаметр переходного
отверстия – 0,3 мм .
7. Параметры отверстий , контактных площадок платы приведены в
таблице 1
8. Плата должна соответствовать ГОСТ 23752-79, группа
жесткости - 3
9. Финишное покрытие металлизированных поверхностей меди по
ГОСТ 9.301-86, контактных зон – припоем ПОС -61 ГОСТ 21930-76
толщиной не менее 35 мкм .
7. Остальные технические требования по ОСТ 4 ГО .070.014-75

Лит Устройство учета | Масса | Масштаб

Изм . Лист | | N °докум . | Подпись | Дата | электронных компонентов Плата печатная | | | | 2:1
Т .контр . Разраб . Провер . | | Гладких А .А .

Кутаев К .С .

Лист | Листов 1

СФ-2-35Г-1.5 ГОСТ 10316-78 | МГТУ им . Н .Э . Баумана Кафедра ИУ 4 Группа ИУ 4-83 Б

Н .контр .
Утв .
