eleven5150/smart-storage/docs/PCB/export/ПЭ3.pdf

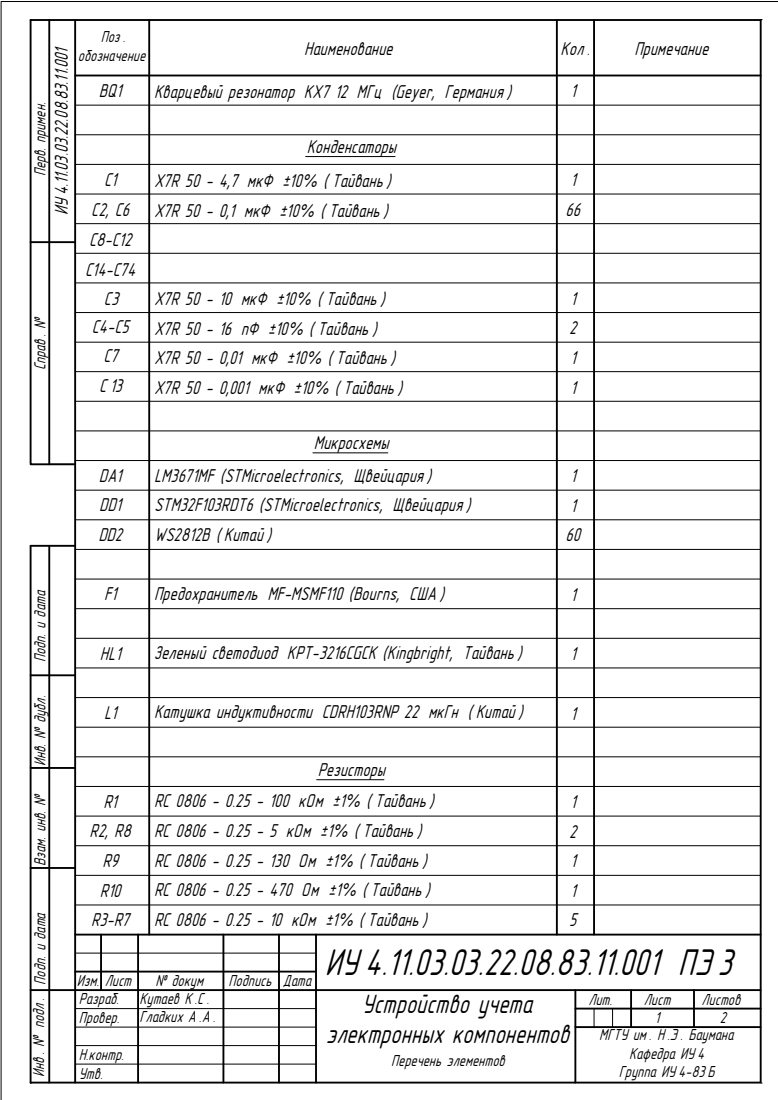
[picture p13: page 1]

Перв. примен. Взам. инв. № Подп. и дата

Инв. № дубл. Подп. и дата

Зеленый светодиод KPT-3216CGCK (Kingbright, Тайвань )

Разраб. | Кутаев К .С . Гладких А .А .
Провер.

Перв. примен. Справ . №

Поз . обозначение | Наименование | Кол . | Примечание
R11-R12 | RC 0806 - 0.25 - 10 кОм ±1% ( Тайвань ) | 2
R13-R14 | RC 0806 - 0.25 - 22 Ом ±1% ( Тайвань ) | 2
Изм. Лист | № докум | Подпись | Дата

Лист

## ИУ 4.11.03.03.22.08.83.11.001 ПЭ 3

| Переключатели
SA1 | SSSS820101 (KLS Electronic, Китай ) | 1
SB1 | SDTM-630-N (KLS Electronic, Китай ) | 1
VT1 | Транзистор BC182LB (Fairchild, США )
| Разъемы
XP1 | PBS-5 (Connfly, Китай ) | 1
XP2 | PBS-3 (Connfly, Китай ) | 1
XS1 | MicroUSB Type-B 47346-0001 (Molex, Китай ) | 1
XS2-XS3 | PLS-6 (Connfly, Китай ) | 2

1

2 Взам. инв. № Подп. и дата Инв. № дубл. Подп. и дата Инв . № подл . ИУ 4.11.03.03.22.08.83.11.001
