eleven5150/smart-storage/docs/PCB/export/СборочныйA2.pdf

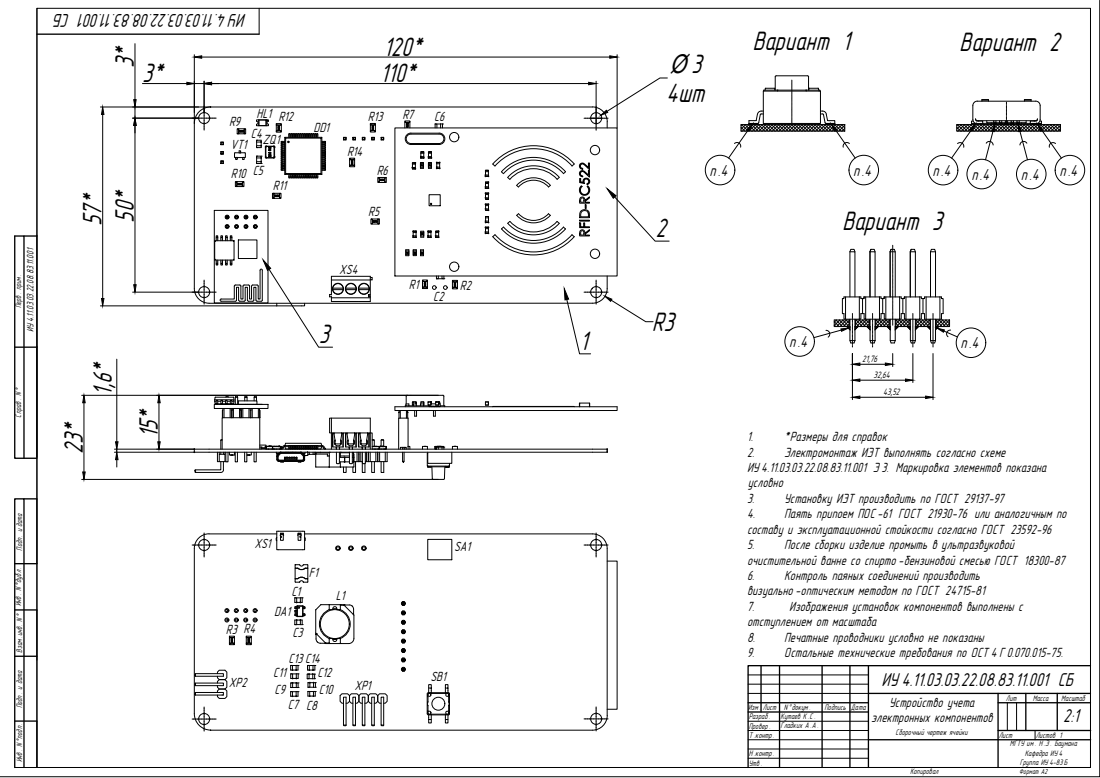
[picture p14: page 1]

1. *Размеры для справок
2. Электромонтаж ИЭТ выполнять согласно схеме
ИУ 4.11.03.03.22.08.83.11.001 Э 3. Маркировка элементов показана
условно
3. Установку ИЭТ производить по ГОСТ 29137-97
4. Паять припоем ПОС -61 ГОСТ 21930-76 или аналогичным по
составу и эксплуатационной стойкости согласно ГОСТ 23592-96
5. После сборки изделие промыть в ультразвуковой
очистительной ванне со спирто -бензиновой смесью ГОСТ 18300-87
6. Контроль паяных соединений производить
визуально -оптическим методом по ГОСТ 24715-81
7. Изображения установок компонентов выполнены с
отступлением от масштаба
8. Печатные проводники условно не показаны
9. Остальные технические требования по ОСТ 4 Г 0.070.015-75.

Подпись | Дата | ИУ 4.11.03.03.22.08.83.11.001 СБ N °докум .

Лит Устройство учета | Масса | Масштаб

Изм . Лист | электронных компонентов Сборочный чертеж ячейки | | | | 2:1
Провер . Т .контр . Разраб .

Лист | Листов 1

Утв . Н .контр .

Кафедра ИУ 4 Группа ИУ 4-83 Б
