eleven5150/smart-storage/docs/PCB/export/СП.pdf

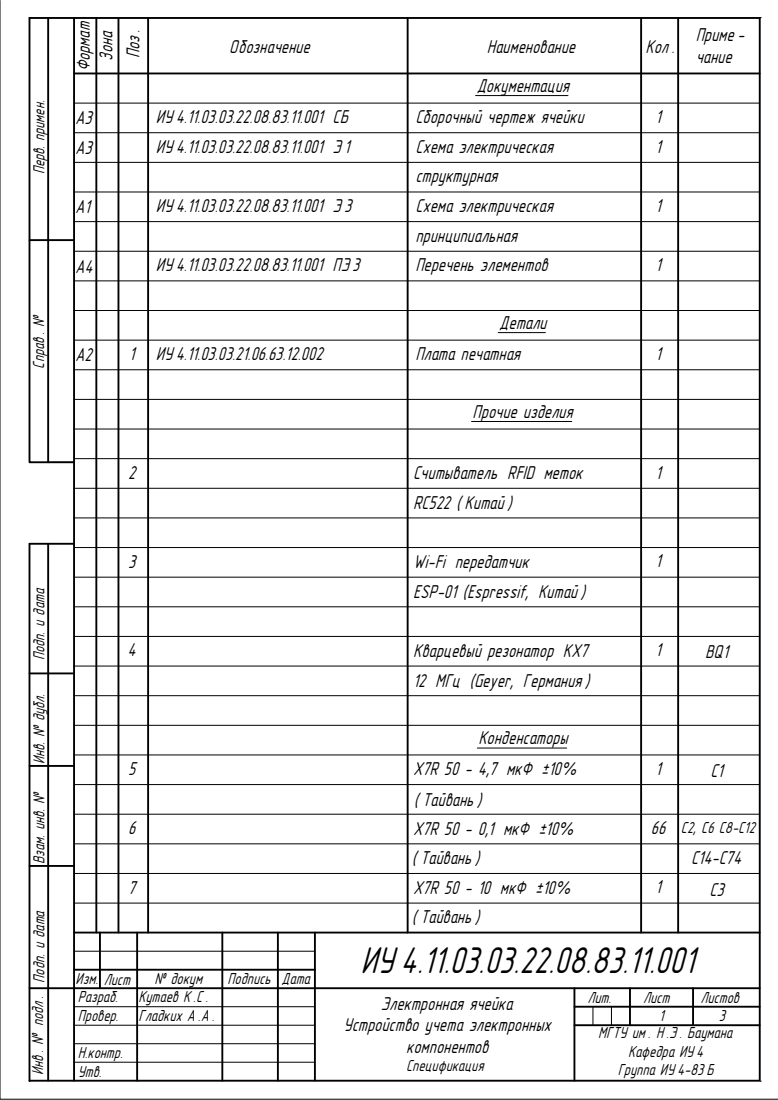
[picture p15: page 1]
Лист; № докум; Подпись; Дата; Наименование; Кол .; Приме -; Сборочный чертеж ячейки; Схема электрическая; Перечень элементов; Плата печатная; Прочие изделия; X7R 50 - 4,7 мкФ ±10%; X7R 50 - 0,1 мкФ ±10%; X7R 50 - 10 мкФ ±10%; ( Тайвань )

Обозначение Поз . Зона Формат

Перв. примен. Взам. инв. № Подп. и дата

Листов Инв . № подл . Справ . №

Считыватель RFID меток
RC522 ( Китай )

Wi-Fi передатчик
ESP-01 (Espressif, Китай )

Инв. № дубл. Подп. и дата

Кварцевый резонатор KX7
12 МГц (Geyer, Германия )

Разраб. | Кутаев К .С . Гладких А .А .
Провер.

Электронная ячейка
Устройство учета электронных

МГТУ им . Н .Э . Баумана
Кафедра ИУ 4
Группа ИУ 4-83 Б

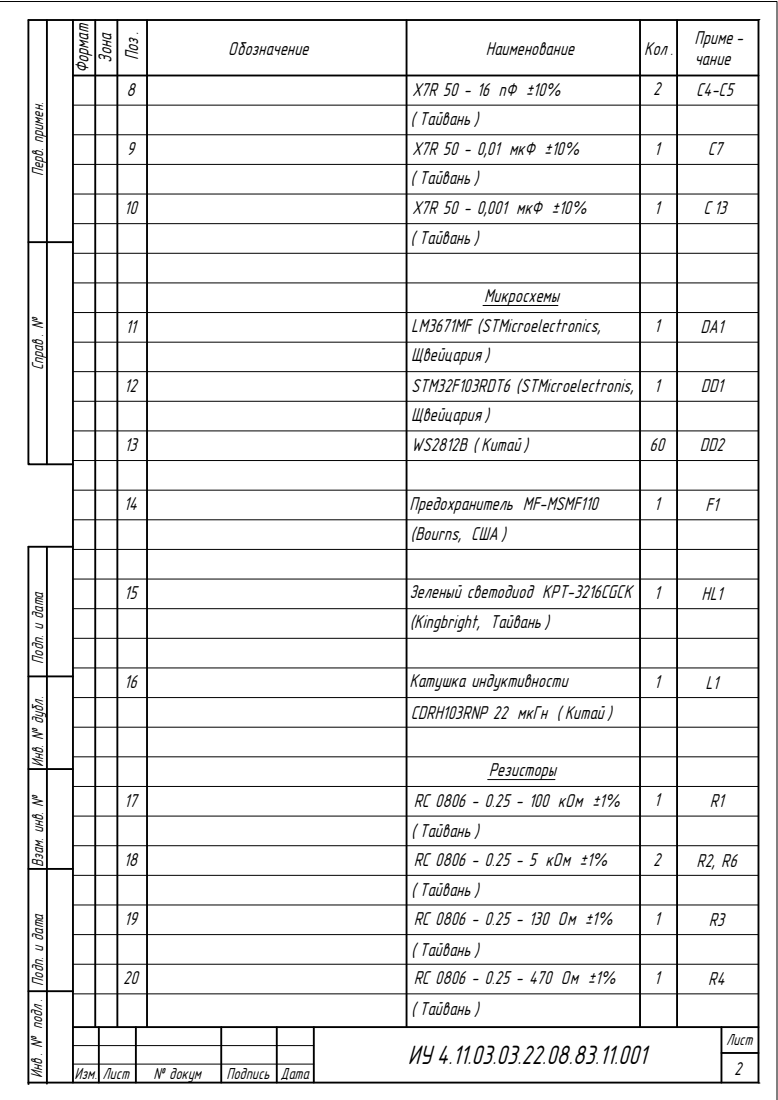
[picture p16: page 2]
Изм. Лист; № докум; Подпись; Дата

Перв. примен. Справ . №

( Тайвань )

9 | X7R 50 - 0,01 мкФ ±10% | 1 | C7

10 | X7R 50 - 0,001 мкФ ±10% | 1 | С 13

Микросхемы

11 | LM3671MF (STMicroelectronics, | 1 | DA1

Щвейцария )

12 | STM32F103RDT6 (STMicroelectronis, | 1 | DD1

13 | WS2812B ( Китай ) | 60 | DD2

14 | Предохранитель MF-MSMF110 | 1 | F1

(Bourns, США )

ИУ 4.11.03.03.22.08.83.11.001 | | 2 Взам. инв. № Подп. и дата Инв. № дубл. Подп. и дата Инв . № подл .

15 | Зеленый светодиод KPT-3216CGCK | 1 | HL1

(Kingbright, Тайвань )

16 | Катушка индуктивности | 1 | L1

CDRH103RNP 22 мкГн ( Китай )

Резисторы

17 | RC 0806 - 0.25 - 100 кОм ±1% | 1 | R1

18 | RC 0806 - 0.25 - 5 кОм ±1% | 2 | R2, R6

Лист

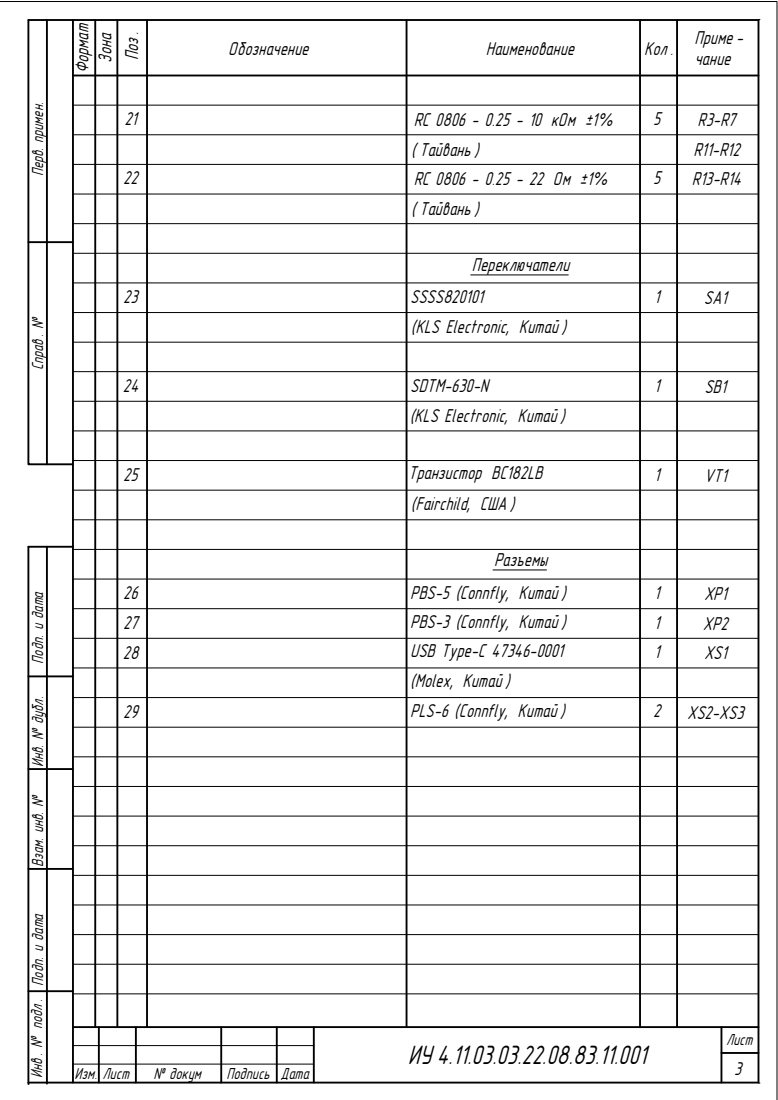
[picture p17: page 3]
Изм. Лист; № докум; Подпись; Дата

Перв. примен. Справ . №

21 | RC 0806 - 0.25 - 10 кОм ±1% | 5 | R3-R7

( Тайвань ) | | R11-R12

( Тайвань )

Переключатели

23 | SSSS820101 | 1 | SA1

(KLS Electronic, Китай )

24 | SDTM-630-N | 1 | SB1

25 | Транзистор BC182LB | 1 | VT1

(Fairchild, США )

Разъемы

ИУ 4.11.03.03.22.08.83.11.001 | | 3 Взам. инв. № Подп. и дата Инв. № дубл. Подп. и дата Инв . № подл .

26 | PBS-5 (Connfly, Китай ) | 1 | XP1
27 | PBS-3 (Connfly, Китай ) | 1 | XP2
28 | USB Type-C 47346-0001 | 1 | XS1

(Molex, Китай )

29 | PLS-6 (Connfly, Китай ) | 2 | XS2-XS3
