eleven5150/smart-storage/cad-src/Altium/Diplom/Export Draftsman/PCBdemo.pdf

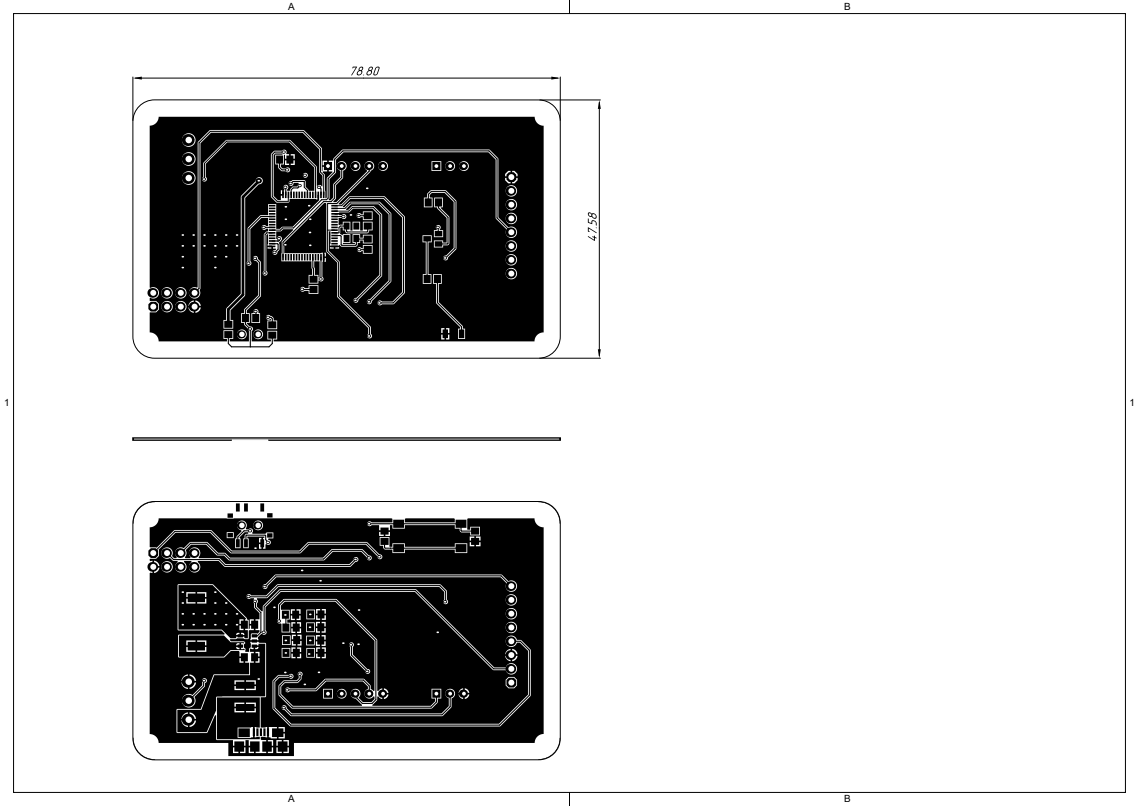
[picture p18: page 1]
