eleven5150/smart-storage/cad-src/Altium/Diplom/Project Outputs for Diplom/Job1.PDF

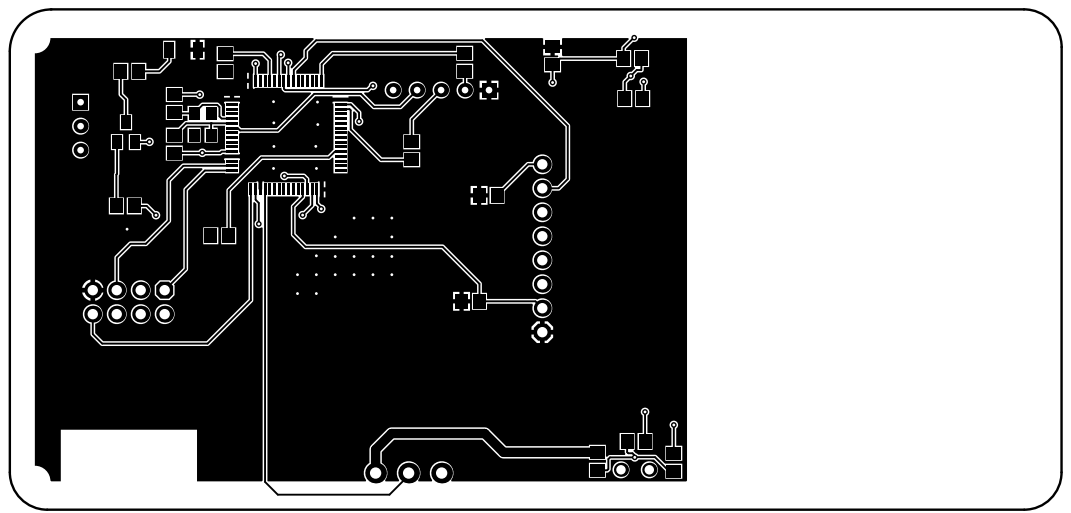
[picture p19: page 1]

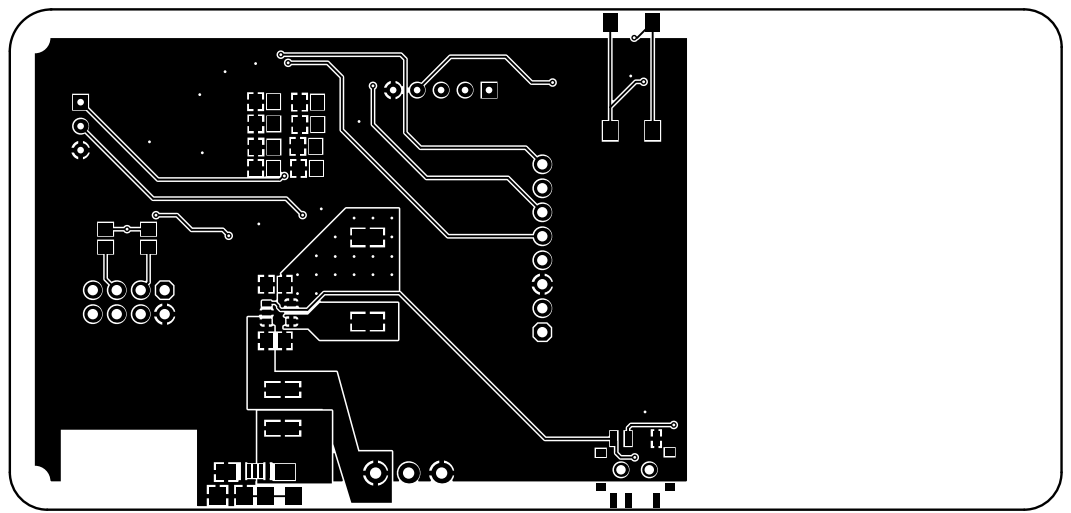
[picture p20: page 2]
