eleven5150/smart-storage/(list of files, drawings)

Other design files:
cad-src/Altium/Diplom/Diplom.PrjPcb
cad-src/Altium/Diplom/DiplomPCB.PcbDoc
cad-src/Altium/Diplom/DiplomScheme.SchDoc
