eleven5150/smart-storage/firmware/Diplom/Core/Src/main.c

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
/* Includes ------------------------------------------------------------------*/
#include "main.h"
#include "dma.h"
#include "spi.h"
#include "tim.h"
#include "usart.h"
#include "gpio.h"


/* USER CODE BEGIN PV */
char str1[250]={0};
typedef struct USART_prop{
  uint8_t usart_buf[250];
  uint8_t usart_cnt;
} USART_prop_ptr;
USART_prop_ptr usartprop = {{0}, 0};

bool ledStripFlag = false;
bool ledStripFlag2 = false;
/* USER CODE END PV */

void SystemClock_Config(void);
/* USER CODE BEGIN 0 */
void string_parse(char* buf_str)
{
//    DEBUG_PRINT(DEBUG_PRINT_INFO, "[ESP] %s\r\n", buf_str);
    if (!strcmp(buf_str, "0,CONNECT\r\n"))
    {
        ledStripFlag = true;
    }
    if (ledStripFlag && !strcmp(buf_str, "\r\n"))
    {
        ledStripFlag2 = true;
    }
}

void UART1_RxCpltCallBack(void)
{
        uint8_t b;
        b = str1[0];
        //если вдруг случайно превысим длину буфера
        if (usartprop.usart_cnt>249)
        {
          usartprop.usart_cnt=0;
          HAL_UART_Receive_IT(&huart1,(uint8_t*)str1,1);
          return;
        }
        usartprop.usart_buf[usartprop.usart_cnt] = b;
        if(b==0x0A)
        {
          usartprop.usart_buf[usartprop.usart_cnt+1]=0;
          string_parse((char*)usartprop.usart_buf);
          usartprop.usart_cnt=0;
          HAL_UART_Receive_IT(&huart1,(uint8_t*)str1,1);
          return;
        }
        usartprop.usart_cnt++;
        HAL_UART_Receive_IT(&huart1,(uint8_t*)str1,1);
}
/* USER CODE END 0 */

/**
  * @brief  The application entry point.
  * @retval int
  */
int main(void)
{
  /* MCU Configuration--------------------------------------------------------*/

  /* Reset of all peripherals, Initializes the Flash interface and the Systick. */
  HAL_Init();

  /* Configure the system clock */
  SystemClock_Config();

  /* Initialize all configured peripherals */
  MX_GPIO_Init();
  MX_SPI1_Init();
  MX_USART2_UART_Init();
  MX_DMA_Init();
  MX_USART1_UART_Init();
  MX_TIM1_Init();
  /* USER CODE BEGIN 2 */
    rfidStatus_t status = MI_ERR;
    RetargetInit(&huart2);
    MFRC522_Init();
    DEBUG_PRINT(DEBUG_PRINT_INFO, "[DEBUG] LedStripStorage started!\r\n");
    HAL_UART_Receive_IT(&huart1,(uint8_t*)str1,1);
    HAL_Delay(1000);

    HAL_GPIO_WritePin(RST_GPIO_Port, RST_Pin, GPIO_PIN_RESET);
    HAL_GPIO_WritePin(RST_GPIO_Port, RST_Pin, GPIO_PIN_SET);
    HAL_Delay(1000);
    HAL_GPIO_WritePin(CH_PD_GPIO_Port, CH_PD_Pin, GPIO_PIN_SET);
    HAL_Delay(1000);
    HAL_UART_Transmit(&huart1, (uint8_t*)"AT+CIPMUX=1\r\n", strlen("AT+CIPMUX=1\r\n"), -1);
    HAL_Delay(1000);
    HAL_UART_Transmit(&huart1, (uint8_t*)"AT+CIPSERVER=1\r\n", strlen("AT+CIPSERVER=1\r\n"), -1);
    HAL_Delay(1000);
  /* USER CODE END 2 */

  /* Infinite loop */
  /* USER CODE BEGIN WHILE */
    uint8_t *pRxData;
    pRxData = (uint8_t *) malloc(sizeof(*pRxData)*48);
    LedController_Load();
    LedController_OffAllLeds();
    while (1)
    {
        if (ledStripFlag2)
        {
            DEBUG_PRINT(DEBUG_PRINT_INFO, "[ESP] %s\r\n", usartprop.usart_buf);
            char a_x_coord[2] = {(char)usartprop.usart_buf[9], '\0'};
            if (!strcmp(a_x_coord, "r"))
            {

                while(status != MI_OK)
                {
                    status = RFID_ReadFullMem();
                }
                DEBUG_PRINT(DEBUG_PRINT_INFO, "[DEBUG] Status %d\r\n", status);
                HAL_UART_Transmit(&huart1, (uint8_t*)"AT+CIPSEND=0,1\r\n", strlen("AT+CIPSEND=0,1\r\n"), -1);
                HAL_Delay(1000);
                HAL_UART_Transmit(&huart1, (uint8_t*)"1\r\n", strlen("1\r\n"), -1);
                HAL_Delay(1000);
                ledStripFlag = false;
                ledStripFlag2 = false;
            }
            else
            {
                DEBUG_PRINT(DEBUG_PRINT_INFO, "[ESP] a_x_coord -> %s\r\n", a_x_coord);
                char a_y_coord[2] = {(char)usartprop.usart_buf[10], '\0'};
                DEBUG_PRINT(DEBUG_PRINT_INFO, "[ESP] a_y_coord -> %s\r\n", a_y_coord);
                int x_coord = atoi(a_x_coord);
                int y_coord = atoi(a_y_coord);
                DEBUG_PRINT(DEBUG_PRINT_INFO, "[ESP] x_coord -> %d\r\n", x_coord);
                DEBUG_PRINT(DEBUG_PRINT_INFO, "[ESP] y_coord -> %d\r\n", y_coord);
                LedController_OnXY(x_coord, y_coord);
                ledStripFlag = false;
                ledStripFlag2 = false;
            }


        }

    /* USER CODE END WHILE */

    /* USER CODE BEGIN 3 */
    }
  /* USER CODE END 3 */
}

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
/* USER CODE BEGIN 4 */
void HAL_UART_RxCpltCallback(UART_HandleTypeDef *huart)
{
    if(huart==&huart1)
    {
        UART1_RxCpltCallBack();
    }
}
/* USER CODE END 4 */
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
