eleven5150/smart-storage/(commit log)

2022-05-14 Configuring led strip
2022-05-24 Added exported and src docs
    [E1 connection.dwg, E1.dwg, Основание.dwg, ПП.dwg, ПЭ3.dwg, СП.dwg, Сборочный.dwg, Э3.dwg]
2022-05-24 Added Крышка, СБ и СП
    [E1 connection.dwg, Крышка.dwg, Основание.dwg, СП.dwg, Сборочный.dwg]
2022-05-26 Fixed silkscreen on Сборочный and package
    [Основание.dwg, Последовательность сборки.dwg, Сборочный.dwg]
2022-05-26 Added Последовательность сборки
    [Последовательность сборки.dwg]
2022-05-30 Excluded protobuf from build and little fix
    [Diplom.ioc]
2022-05-31 Измерительный стенд started
    [Измерительный стенд.dwg]
2022-05-31 Added Эксперимент
    [Эксперимент.dwg]
2022-05-31 Added demo РПЗ
2022-06-01 Added введение
2022-06-01 Измерительный стенд finished
    [Измерительный стенд.dwg]
2022-06-01 Added РТЗ
2022-06-01 Added Глава 1
2022-06-02 Fixed mistakes on Э1
    [E1 connection.dwg, E1.dwg]
2022-06-02 Added Глава 2 и 3
2022-06-05 Fix material
2022-06-05 Added Глава 4 и 5
2022-06-06 Updated ПЭ3
    [ПЭ3.dwg]
2022-06-07 Added 6 глава
2022-06-07 Added 7 глава
2022-06-08 Added Заключение
2022-06-08 Fixed device СП
    [СП.dwg]
2022-06-09 Fixed Solo remarks
    [Крышка.dwg, Основание.dwg]
2022-06-09 Added Алгоритм
    [Алгоритм.dwg]
2022-06-10 Added Список источников
2022-06-11 Finally staged antiplagiat
2022-06-12 Changed formats
    [Сборочный.dwg, СборочныйA2.dwg, Эксперимент.dwg, ЭкспериментA3.dwg]
2022-06-12 Added final print pages
    [Page1.dwg, Page2.dwg, Page3.dwg, Сборочный.dwg, ЭкспериментA3.dwg]
2022-06-12 Added ledstrip flashing
2022-06-13 LedStrip finally works
2022-06-20 Added CAD source files
    Files from Altium and Inventor
    [Assembly.dwg, AssemblyA.dwg, AssemblyANew.dwg, Device.dwg, Device.iam, DeviceForScheme.iam, Diplom.PrjPcb, DiplomPCB.PcbDoc]
