eleven5150/smart-storage/(notices)

Notices in the files:
firmware/Diplom/Core/Src/main.c:
© Copyright (c) 2022 STMicroelectronics.
All rights reserved.
This software component is licensed by ST under BSD 3-Clause license,
the "License"; You may not use this file except in compliance with the
License. You may obtain a copy of the License at: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
firmware/Diplom/Core/Inc/main.h:
(C) COPYRIGHT STMicroelectronics *****END OF FILE
